towni0/TSEA29---MrRobot/README.md

# TSEA29---MrRobot
TSEA29 bygga robot projekt
test
