towni0/TSEA29---MrRobot/docs/TSEA29-presentation-v.01.pptx

## Mr.Robot

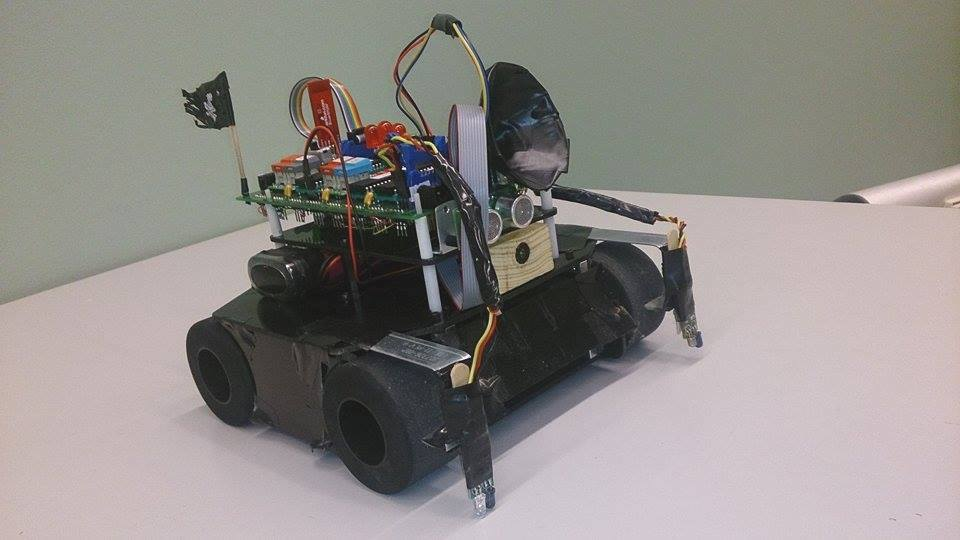
[picture p28: figure]

## INTRODUKTION

Namn | Ansvar
Johan Olin | Projektledare
Per Olin
Mattias Ulmstedt
Joacim Stålberg
Tor Utterborn | Dokumentationsansvarig
Hans Tchou

## Inledning

Bakgrund:
- TSEA29
- 6 gruppmedlemmar
Syfte:
- Lära oss mer om mikroprocessorer
- Arbeta i större projekt
Uppdrag:
- Konstruera en kamprobot
Budget:
- 960 timmar sammanlagt

## PRODUKT

Ingående i produkt:
  - Autonom kamprobot
  - Teknisk dokumentation
  - Användarmanual
  - Mjukvara till persondator

## Kamprobot

Vad kan roboten göra?
  - Åka runt i en bana
  - Skanna ett område efter fiender
  - Skjuta på fiender
  - Skicka sensordata till PC
  - Kollisionssäker*

*Väldigt liten chans att kollidera med något framför roboten

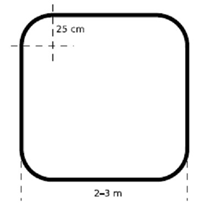
[picture p29: figure]

## Systemöversikt

- Tre delsystem

- UART

- Bluetooth


## Sensorenheten – ”Sinnena”

Ingående komponenter:
- Ultraljudssensor
- Lasersensor
- IR-sensor
- Tejpsensor x 2
- Gyro

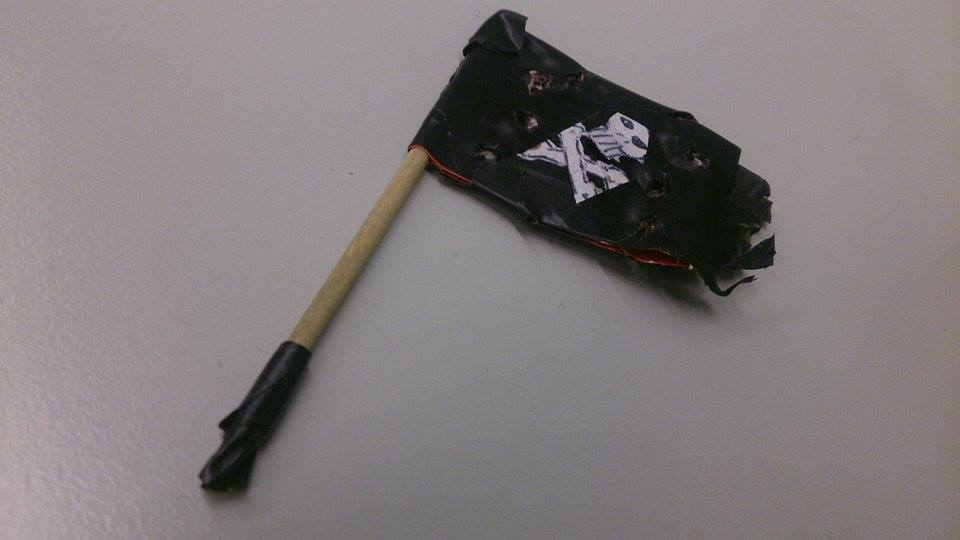
[picture p30: figure]

## Ultraljudssensor

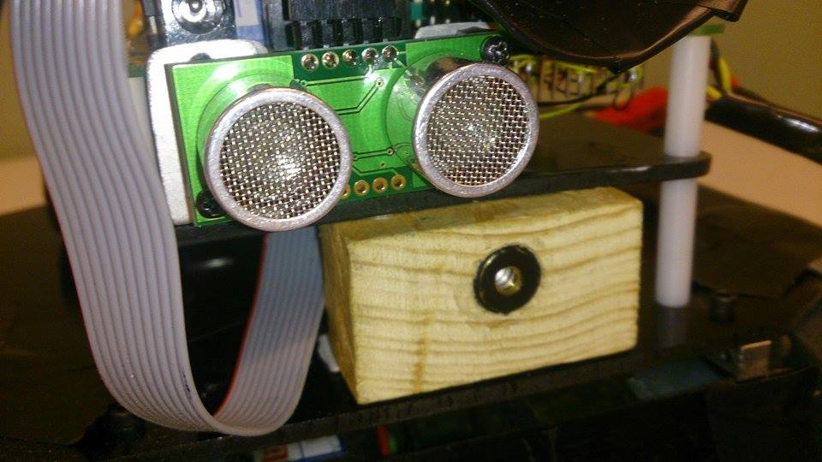
[picture p31: figure]

## Lasersensor

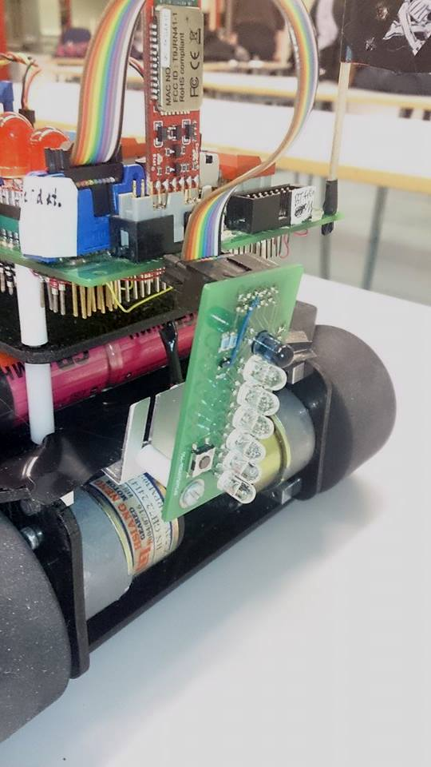
[picture p32: figure]

## IR-sensor

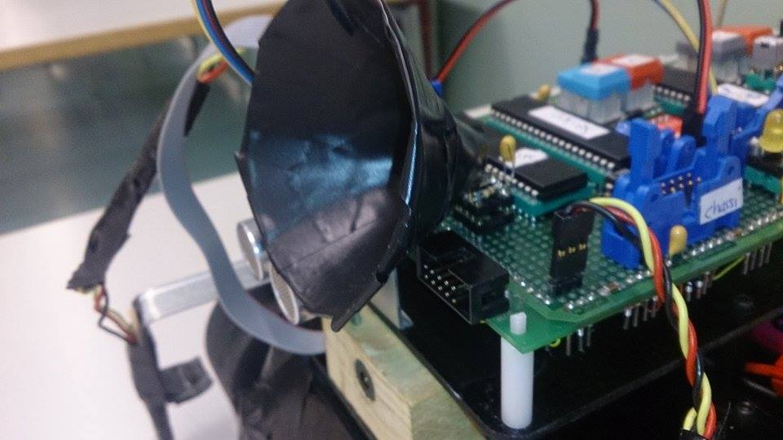
[picture p33: figure]

## Tejpsensor

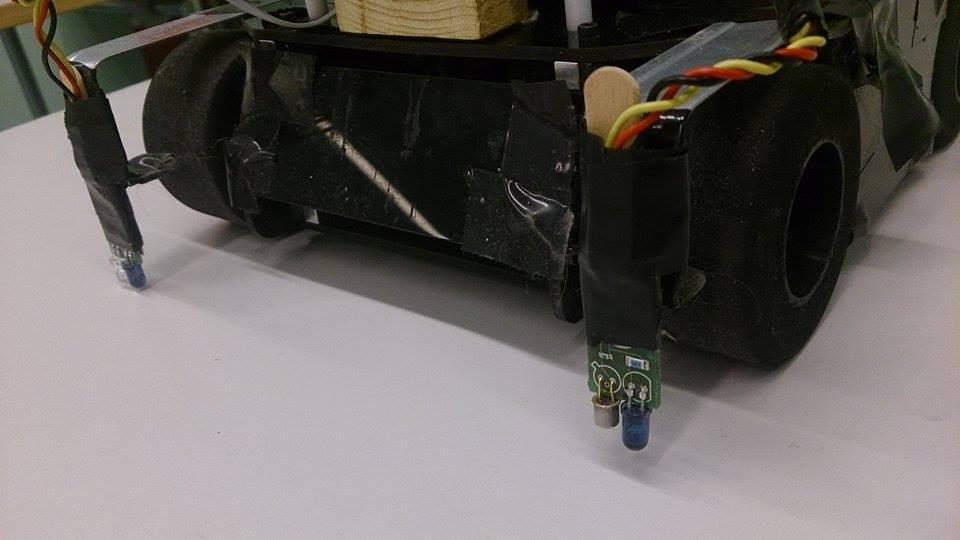
[picture p34: figure]

## Gyro

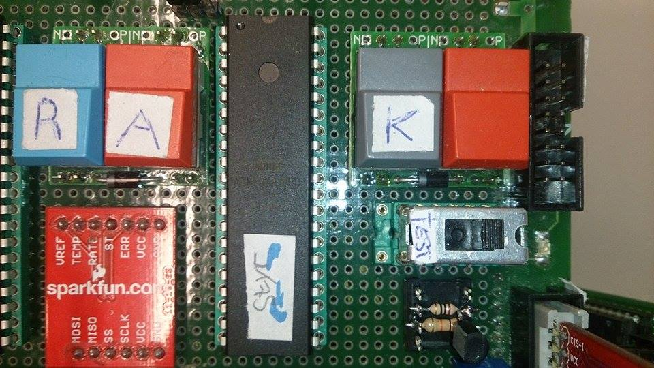
[picture p35: figure]

## Sensorenheten – ”Sinnena”

- Hämtar rådata från sensormoduler
- Skickar data till målsökningsenheten

## Målsökningsenheten – ”Hjärnan”

- ”Utför all logik”
- Skickar order till styrenheten
- AI – 2 olika lägen

## AI -


Notes: Om vi har tid kan man beskriva detta i en simplifierad version

## Styrenheten – ”Slaven”

Styrkomponenter:
- Två par motorer
- IR-sändare
- Laserkanon
- Lysdiod x 5

## IR-sändare

## Laserkanon

## Lysdioder

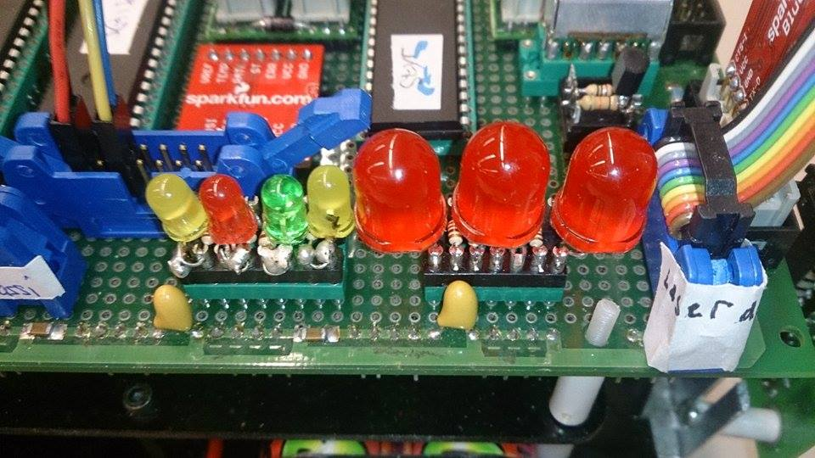
[picture p36: figure]

## Bluetooth - Firefly

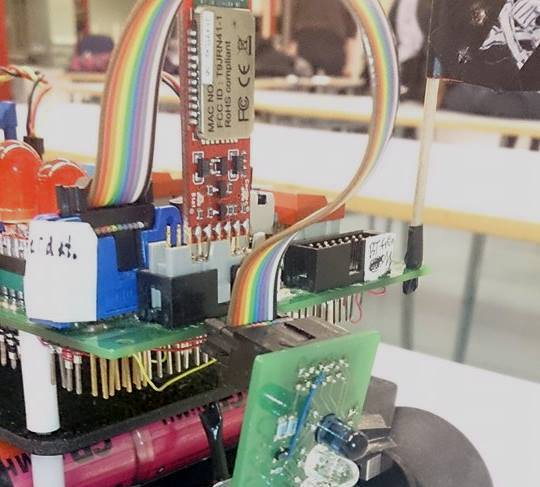
[picture p37: figure]

## Styrenheten – ”slaven”

- Bluetooth – enkelriktad
- Tar emot order från målsökningsenheten

## GUI


- Användning
- Kod: Java

## Arbetsmetod

- Nerifrån och upp  Lösning av problem: - Analysera - Brainstorm - Åtgärda
- Testa, testa, testa!

## Resultat

- En färdig produkt som uppfyller kravbild
- Leverans inom tidsram
- Som grupp mer erfarna och nöjda med produkten

## Slide 25

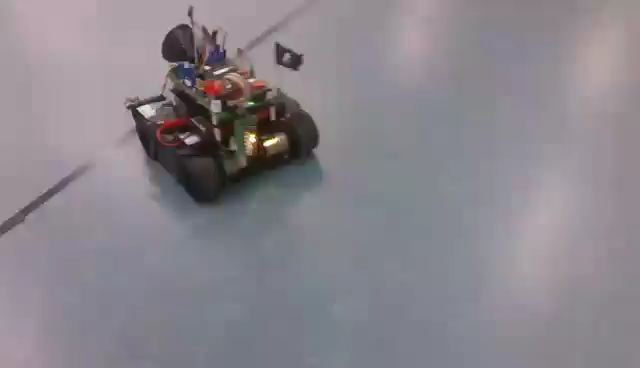
[picture p38: figure]

## Vidareutveckling

- Modulär
- Fjärrstyrning
- Oändliga möjligheter

## Varför oss?

- Potential (First!!111)
- Genomtänkt
- Ambitiöst

## Avslut

Frågor?
