towni0/TSEA29---MrRobot/docs/datablad/lasermodul.pdf

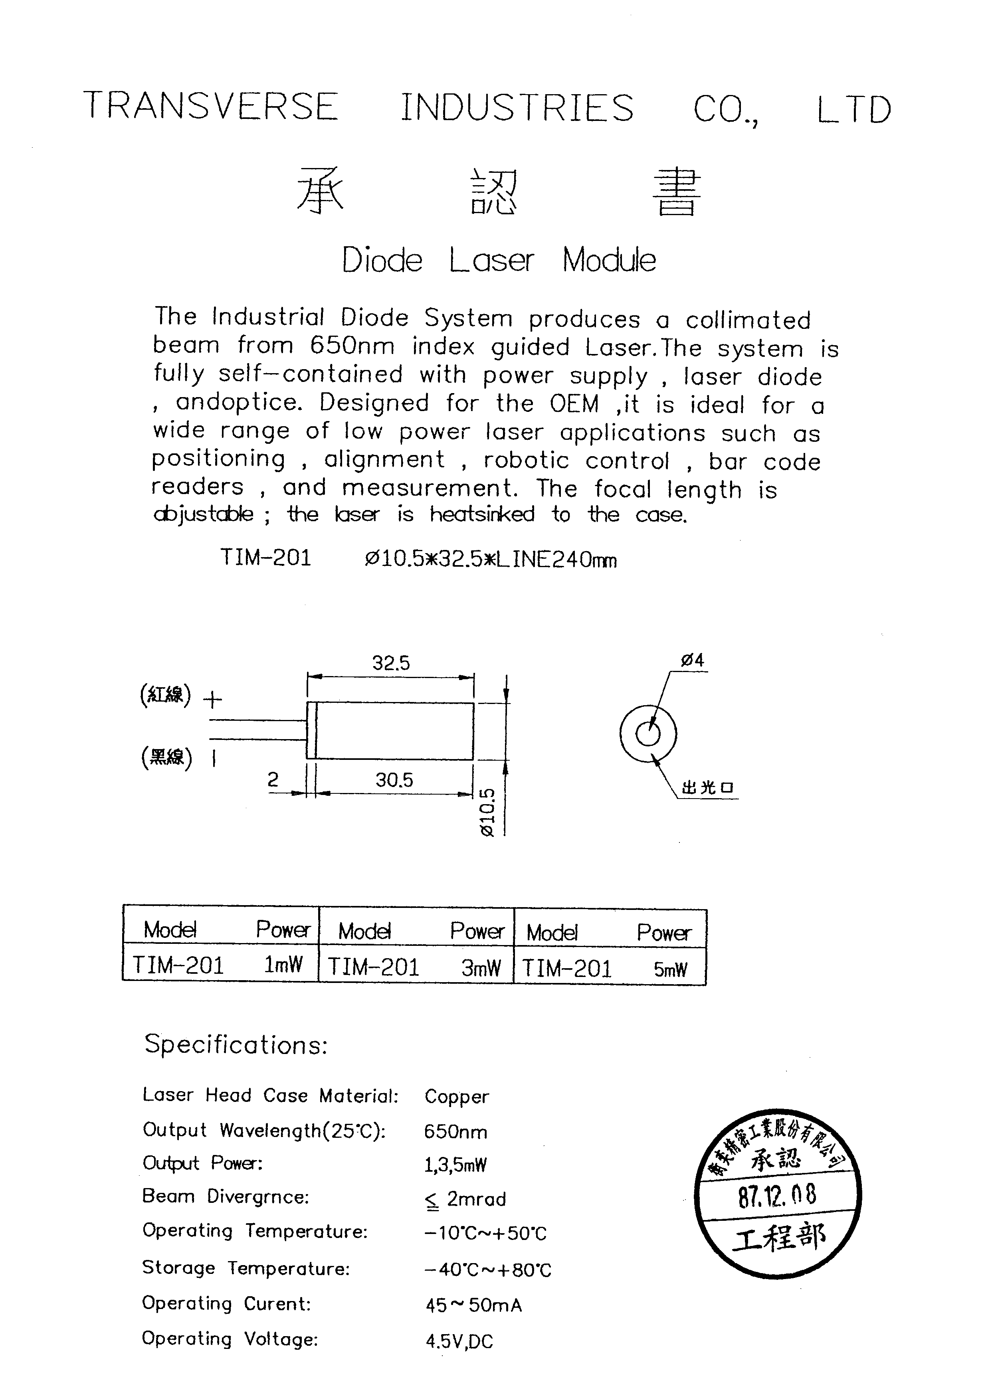
[picture p48: page 1]
