towni0/TSEA29---MrRobot/docs/TSEA29 - Kamprobot - Grupp 15 - Tiddsrapport 5.xlsx

Sheet: Basplan
Basplan
Projekt: |  | Kamprobot
Projektgrupp: |  | 15 |  | Datum: |  |  |  |  |  |  |  |  | Granskad:
Beställare: |  | Tomas Svensson |  | Version: |  | 1.0
Kurs: |  | TSEA29 |  | Utfärdare: |  | JO
AKTIVITETER |  |  | TID | VEM | TIDPLAN (när), veckonummer
Nr | Beskrivning |  | timmar | Initialer | 40 | 41 | 42 | 43 | 44 | 45 | 46 | 47 | 48 | 49 | 50 | 51 | 1 | 2 | 3 | 4 | 5 | 6 | 7 | 8 | 9 | 10 | 11
1 | Avståndssensorerna kan skicka data |  | 10 | JO,PO |  |  |  |  |  | 10 |  |  |  |  |  |  |  |  |  |  |  |  |  |  |  |  |  | 10
2 | Sensorenheten kan ange avstånd till föremål. |  | 10 | PO,JO |  |  |  |  |  | 10 |  |  |  |  |  |  |  |  |  |  |  |  |  |  |  |  |  | 10
3 | IR-sensorn kan skicka data till sensorenheten |  | 10 | TU,HT |  |  |  |  |  | 10 |  |  |  |  |  |  |  |  |  |  |  |  |  |  |  |  |  | 10
4 | Sensorenheten kan identifiera en “fyr” |  | 10 | HT,TU |  |  |  |  |  | 10 |  |  |  |  |  |  |  |  |  |  |  |  |  |  |  |  |  | 10
5 | Linjesensorn kan skicka data till sensorenheten |  | 10 | MU,JS |  |  |  |  |  | 10 |  |  |  |  |  |  |  |  |  |  |  |  |  |  |  |  |  | 10
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
