towni0/TSEA29---MrRobot/docs/pics/målsökningsenhet.png

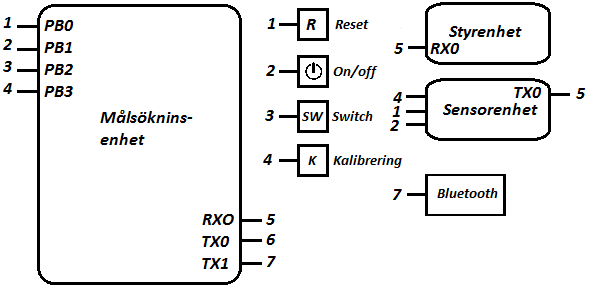
docs/pics/målsökningsenhet.png
