towni0/TSEA29---MrRobot/docs/pics/Sensorenhet.png

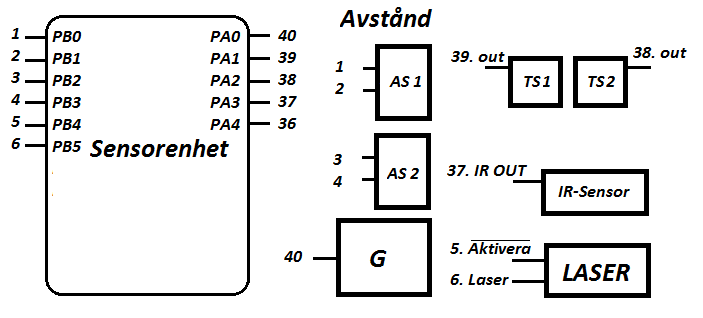
docs/pics/Sensorenhet.png
