towni0/TSEA29---MrRobot/docs/pics/Systembild.png

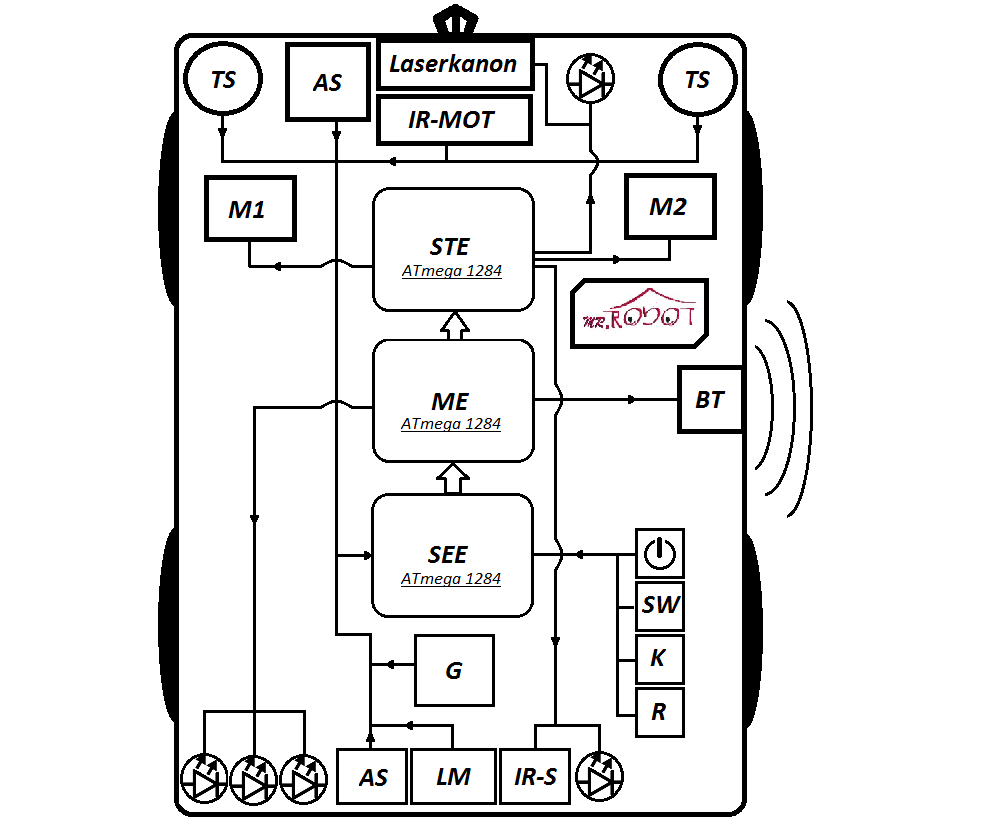
docs/pics/Systembild.png
