towni0/TSEA29---MrRobot/docs/pics/Systembildv3.png

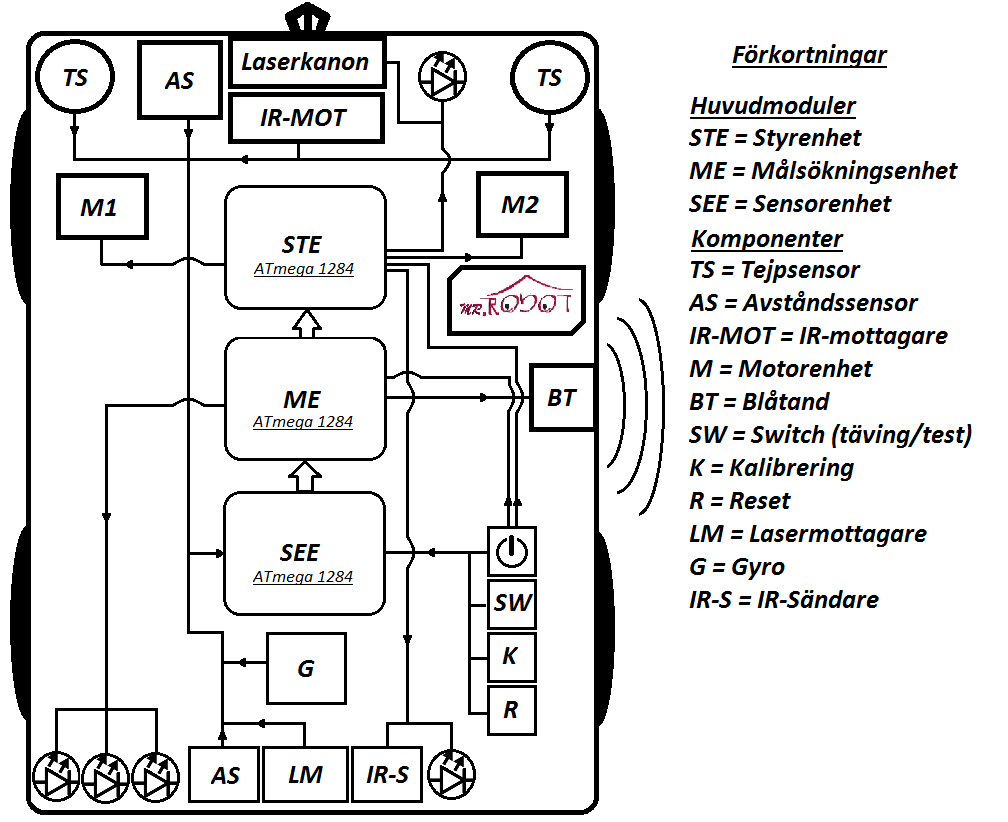
docs/pics/Systembildv3.png
