towni0/TSEA29---MrRobot/code/Sensorenheten/Sensorenheten/Sensorenheten.cpp

/*
 * Sensorenheten
 * 
 * TSEA29 Group 15
 * Programmerare: Joacim Stålberg, Mattias Ulmstedt, Tor Utterborn, Hans Tchou, Johan Olin och Per Olin.
 * LIU
 */ 

#include "../../Robotdefinitions.h"
#include "util/delay.h"

#define GYRO		0
#define TAPESENSOR1 1
#define TAPESENSOR2 2

//initial values are set to their IDs from design spec. (these bits are never changed)
uint8_t message1 = 0b00110000;
uint8_t message2 = 1;
uint8_t message3 = 2;
uint8_t message4 = 3;
uint8_t message5 = 4;

uint8_t ADCcount = 1;

uint8_t messageNumber = 1;


void waitForActivationSensor();
uint8_t tapeCheck(uint16_t message, uint8_t tapeSensorNumber);
void clearADCMUX();

//###############
//## IR SENSOR ##
//###############

#define IRheader 20
#define IROneValueMin 9
#define IROneValueMax 13
#define IRZeroValueMin 4

bool compareSignature(uint8_t* oursignature, uint8_t* signature);
void IRSensorFunction();
bool enemy = false;
uint8_t signature[] = {0,0,0};
uint8_t signatureS = 0;
uint8_t oursignature[] = {1,1,0};
int index = 0;
int IRcount = 0;
bool headerPhase = false;
bool signaturePhase = false;
bool pause = false;

//########################
//## Ultrasonic Sensors ##
//########################

void ultrasonicFunction();
void StartPulse();
void CalculateTime();
void resetTimerValues();
float calculateDistance();

// Variables
int timer = 0;

uint8_t distancecm1 = 0; //Ultrasonic sensor 1 distance [cm]
uint8_t distance1 = 0; //Ultrasonic sensor 1 distance [dm]

bool triggerStarted = false;
bool triggerSend = false;

bool timerStarted = false;
bool timeTaken = false;

//laser
void laserSensorFunction();

uint8_t laser;
uint8_t secsSinceLaserHit = 0;
bool waitLaserActivation = false;
bool laserIniated = false;


int main(void)
{
	//init µcontroller
	DDRD &= ~(1<<PIND7); //Aktiveringsknapp (in)
	DDRB = 0b00011110;
		
	//enable global interrupt
	sei();
	
	//Ultrasonic
	TCCR2B |= 1 << CS20; // Start timer
	TCNT2 = 0;
	
	//###############
	//## ADC INITS ##
	//###############
		
	//turn on ADC
	ADCSRA |= (1 << ADEN);
	//Set ADC clock to 1000 000 / 128 Hz
	ADCSRA |= (1 << ADPS2) | (1 << ADPS1) | (1 << ADPS0) ;
	//ADC interrupt enabled
	ADCSRA |= (1 << ADIE);
	//mux PINA0, start with TAPE
	ADMUX |= (1<<PINA0);
	
	//################
	//## UART INITS ##
	//################
	
	//initiate UART målsökning
	//set baud rate
	uint16_t UBRR_val = UBRR_SENSOR_MALSOKNING;
	UBRR0H = (unsigned char) (UBRR_val >> 8);
	UBRR0L = (unsigned char) UBRR_val;
	//enable transmit + set frame 8 bits
	UCSR0B = (1<<TXEN0);
	UCSR0C = (1<<UCSZ00) | (1<<UCSZ01);
	//enable transmit interrupt
	UCSR0B |= (1<<TXCIE0);
	
	//inactivate, must wait for power up
	_delay_ms(100);
	PORTB |= (1 << LASER_AKTIVERA_PORT);
	_delay_ms(10);
	PORTB &= ~(1 << LASER_AKTIVERA_PORT);
	
	//## IR Sensor ##
	TCCR1B |= 1 << CS10;
	
	//Start 1st ADC conversion
	ADCSRA |= (1 << ADSC);
	
	waitForActivationSensor();
	
	//start first UART transmission
	UDR0 = 0x00;
	
	//Main loop
    while(1)
    {
		//###############
		//## IR SENSOR ##
		//###############

		IRSensorFunction();
		
		//##################
		//## Laser sensor ##
		//##################
		
		laserSensorFunction();
		
		//########################
		//## Ultrasonic Sensors ##
		//########################
		
		ultrasonicFunction();
	}
	
}

/*
	Interrupt function for sending UART
*/
ISR(USART0_TX_vect){
	cli();
	//mux through messages
	switch(messageNumber){
		case 1:
			UDR0 = message1;
			break;
		case 2:
			UDR0 = message2;
			break;
		case 3:
			UDR0 = message3;
			break;
		case 4:
			UDR0 = message4;
			break;
		case 5: 
			UDR0 = message5;
			break;
	}
	
	//next mux
	messageNumber++;
	if(messageNumber>NUMBER_OF_MESSAGES) messageNumber=1;
	
	//enable interrupts
	sei();
}

/*
	Interrupt function for ADC
*/
ISR(ADC_vect){
	cli();
	uint8_t lowbits = ADCL;
	uint16_t message = ADCH <<8 | lowbits;
	//enable interrupts
	sei();
	uint8_t inbetween = 0;
	switch(ADCcount){
		case GYRO:
			message >>= 2; //Divide by 4
			message4 &= 0b00000111; //Reset bits
			message4 |= (message<<LOWERBITSGYRO_INDEX);
			message5 &= 0b11000111; //Reset bits
			message5 |= ((message>>2) & 0b00111000);
			clearADCMUX();
			ADMUX |= 1;
			break;
		case TAPESENSOR1:
			//clear TAPESENSOR1_INDEX bit
			message5 &= 0b10111111;
			tape1CurrentValue = message; //Save current value, used for calibration
			//mask in actual value
			//debug
			message3 &= 0b00000111;
			inbetween = (message >> 5);
			message3 |= (inbetween << 3);
			//!!!
			message5 |= (tapeCheck(message, 1)<<TAPESENSOR1_INDEX);
			//next muxed ADC
			clearADCMUX();
			ADMUX |= 2;
			break;
		case TAPESENSOR2:
			//clear TAPESENSOR2_INDEX bit
			message5 &= 0b01111111;
			tape2CurrentValue = message; //Save current value, used for calibration
			//mask in actual value
			message5 |= (tapeCheck(message, 2)<<TAPESENSOR2_INDEX);
			//next muxed ADC
			clearADCMUX();
			//MUX to IRSENSOR-ADC?
			break;
	}
	
	ADCcount++;
	//go around
	if(ADCcount >= NUMBER_OF_ADC_SENSORS){
		 ADCcount = 0;
		 clearADCMUX();
	}
	
	//Start next conversion
	ADCSRA |= (1 << ADSC);
}

/*
	Check if the converted value from the tape sensors indicate tape or not.
	Returns 1 if tape.
*/
uint8_t tapeCheck(uint16_t message, uint8_t tapeSensorNumber){
	if((tapeSensorNumber == 1 && message >= tape1Threshold) || (tapeSensorNumber == 2 && message >= tape2Threshold)){
		return 1;
	}
	else{
		return 0;
	}
}

/*
	Resets the MUX counter for the ADC.
*/
void clearADCMUX(){
	ADMUX &= 0b11100000;
}

/*
	Resets timer 2.
*/
void resetTimerValues() {
	TCNT2 = 0;
	timer = 0;
}

/*
	Startpulse for the ultrasonic sensor.
*/
void StartPulse() {
	//set trigger to high
	if (!triggerStarted) {
		triggerStarted = true;
		PORTB |= (1 << PULSE_TRIGGER_PIN1);
		resetTimerValues();
	}
	
	//set trigger to low
	if (triggerStarted && timer == 10) { // and at least 15 us has passed.
		triggerSend = true;
		PORTB &= ~(1 << PULSE_TRIGGER_PIN1);
		resetTimerValues();
	}
}


/*
	Calculates the time that the pulse to took return.
*/
void CalculateTime() {
	//when echo output is high, start timer.
	if (!timeTaken && triggerSend && !timerStarted && (PINB & (1<<ECHO_PIN1))) {
		timerStarted = true;
		resetTimerValues();
		
	}
	
	//when echo output is low, stop timer. (save time)
	if (!timeTaken && triggerSend && timerStarted && !(PINB & (1<<ECHO_PIN1))) {
		//set timer variables to zero.
		// CalculateDistance returns a value in cm we need it in dm
		distancecm1 = calculateDistance();
		//check singular number to do correct round up or down
		int singular = (distancecm1 % 100) % 10;
		if(singular >= 5){ 
			distance1 = distancecm1/10 + 1;
		}
		else{
			distance1 = distancecm1/10;
		}
		message2 &= ~(0b11111<<3); //Reset distance bits
		message2 |= (distance1<<3); //Set UART message with new distance
		
		resetTimerValues();
		timeTaken = true;
	}
}


/*
	Returns the distance from the ultrasonic sensor.
*/
float calculateDistance() {
	//each timer tick represent MICRO_SEC_PER_TICK ms
	int uTime = timer * MICRO_SEC_PER_TICK;
	//magic formula to get centimeter
	float centiMeters = uTime/58;
	//cap max distance to 240 cm because faulty sensor at high values
	if (centiMeters > 240) return 240;
	return centiMeters;
}

/*
	Returns true if the signatures are the same.
*/
bool compareSignature(uint8_t* oursignature, uint8_t* signature){
	for (int i = 0; i<3;i++){
		if (oursignature[i] != signature[i]){
			return false;
		}
	}
	return true;
}

/*
	Checks for hit and reactivates the laser sensor 5 seconds after hit.
*/
void laserSensorFunction(){
	if(TCNT3 >= 18000){
		secsSinceLaserHit++;
		TCNT3 = 0;
	}
	if(secsSinceLaserHit >= 5){
		//inactivate
		PORTB |= (1 << LASER_AKTIVERA_PORT);
		//reset count
		if(!waitLaserActivation){
			TCNT3 = 0;
			waitLaserActivation = true;
		}
		//activate, might have to wait if this is too fast here we wait 10 more clock ticks
		if(TCNT3 >= TICKS_TO_WAIT_FOR_ACTIVATE_LASER){
			PORTB &= ~(1 << LASER_AKTIVERA_PORT);
			TCCR3B &= 0b11111000; //Reset pre-scaler to stop counting
			TCNT3 = 0; //Reset counter
			secsSinceLaserHit = 0;
			waitLaserActivation = false;
		}
	}
	
	//mask LASER bit
	laser = (PINB>>5);
	laser &= 0b00000001;
	if(laser == 0b00000001){
		message1 &= 0b10111111; //Reset laser bit
		message1 |= (laser<<LASER_INDEX); //Mask in new laser bit
		//Start timer with pre-scaler 1024
		TCCR3B |= (1<<CS32) | (1<<CS30);
	}
	else{
		//no hit
		message1 &= 0b10111111;
	}
}

/*
	Drive the ultrasonic sensor and calculate distance
*/
void ultrasonicFunction(){
	//in here every 100 us
	if (TCNT2 > 184) {
		PORTC ^= (1<<PINC1);
		timer++;
		TCNT2 = 0;
	}
	
	if (!triggerSend) {
		StartPulse();
	}
	CalculateTime();
	
	//wait at least 10msec
	if (timeTaken && timer == 1000) {
		triggerSend = false;
		triggerStarted = false;
		timerStarted = false;
		timeTaken = false;
	}
}

/*
	Wait for press on activation button.
*/
void waitForActivationSensor(){
	while((PIND>>PIND7) == 0){
		//Calibrate tape sensor if the calibration button is pressed.
		if((PINB>>PINB7) == 0){
			cli();
			tape1Threshold = tape1CurrentValue - TAPE1_ERROR_MARGIN; 
			tape2Threshold = tape2CurrentValue - TAPE2_ERROR_MARGIN; 
			sei();
		}
	}
	return;
}



/*
	Reads IR-signatures from the IR-sensor
*/
void IRSensorFunction(){
	// If 100 us have passed
	if (TCNT1 > 1842){ //Timer counter
		IRcount++;
		TCNT1 = 0;
	}
	
	//start with looking for header
	if(!headerPhase && !signaturePhase){
		if(bit_is_clear(PINB, 6)){ // check if header can start
			headerPhase = true;
			IRcount = 0;
		}
	}
	else if(headerPhase && !signaturePhase){
		//if header is too short or long redo
		if(bit_is_set(PINB, 6) && ((IRcount < IRheader) || (IRcount > IRheader + 6))){
			headerPhase = false;
		}
		else if(bit_is_set(PINB, 6) && IRcount >= IRheader){
			signaturePhase = true;
			index = 0;
			IRcount = 0;
			pause=true;
		}
	}
	
	if(signaturePhase){
		//pauses should be detected as +~400us signals
		if(pause){
			//if the pause is too short or long we have a mess
			if(bit_is_clear(PINB, 6) && ((IRcount < 5) || (IRcount > 7))){
				signaturePhase = false;
				headerPhase = false;
			}
			//if pause is between ~300 to 700 we accept it
			else if(bit_is_clear(PINB, 6)){
				pause=false;
				IRcount = 0;
			}
		}
		else{
			//if signal was too short or too long we have mixed signal or header
			if(bit_is_set(PINB, 6) && ((IRcount < IRZeroValueMin) || (IRcount > IROneValueMax))){
				signaturePhase = false;
				headerPhase = false;
			}
			//accept ~1100 to 2000us as a 1
			else if(bit_is_set(PINB, 6) && IRcount > IROneValueMin){
				signature[index] = 1;
				index++;
				pause = true;
				IRcount = 0;
			}
			//accept 3-10 as a 0 ~300 us to 1000 us
			else if(bit_is_set(PINB, 6)){
				signature[index] = 0;
				index++;
				pause = true;
				IRcount = 0;
			}
		}
	}
	
	//if full signature has been picked up
	if(index == 3){
		if (compareSignature(oursignature, signature)){
			enemy = false;
		}
		else {
			enemy = true;
		}
		headerPhase = false;
		signaturePhase = false;
		index = 0;
		IRcount = 0;
		
		//Set UART message
		signatureS = (signature[0]<<2) | (signature[1]<<1) | signature[2];
		message1 &= ~(0b111<<IRSIGNATURE_INDEX); //Reset signature in message
		message1 |= (signatureS<<IRSIGNATURE_INDEX); //Set new signature
		(enemy ? message1 |= (1<<IRSENSOR_INDEX) : message1 &= ~(1<<IRSENSOR_INDEX));
		//send signature in message3 for debug(old ultrasonic sensor 2)
		message3 &= 0b00000111;
		message3 |= (signatureS << 3);
	}
	
	//update with our signature (default) if no signature spotted
	if (IRcount == IRheader * 10){
		enemy = false;
		//Set UART message
		signatureS = (oursignature[0]<<2) | (oursignature[1]<<1) | oursignature[2];
		message1 &= ~(0b111<<IRSIGNATURE_INDEX); //Reset signature in message
		message1 |= (signatureS<<IRSIGNATURE_INDEX); //Set new signature
		(enemy ? message1 |= (1<<IRSENSOR_INDEX) : message1 &= ~(1<<IRSENSOR_INDEX));
		//send signature in message3 for debug(old ultrasonic sensor 2)
		message3 &= 0b00000111;
		message3 |= (signatureS << 3);
	}
	
}
