towni0/TSEA29---MrRobot/(commit log)

2015-10-07 Dokument som beskriver laserkanon, lasersensor samt tejpsensor tillagda
2015-10-07 IR-Sensor, Systembild new file: docs/IR-sensor.docx new file: docs/datablad/ir-sensor-8601s.pdf new file: docs/pics/Systembild.png
2015-10-13 Create Pseudokod Sensorenhet
2015-10-13 motorer och sensorenhet pseudo
2015-10-14 Lagt till ADC BT Gyrotext
2015-10-14 kompletterande IR-sensor
2015-10-22 Uppdaterat designspecifikation till v1.0 samt ändra de saker Olov ville att vi skulle ändra
2015-11-03 Tidsplan
    Lagt in tidsplan
    [TSEA29MRROBOT1.0.xlsx]
2015-11-15 Projekt mappar till atmelstudio styrenhet, sensorenhet, målsöknings, lasersensor
2015-11-19 Tog bort all gammal text vi använde för att skapa designspecifikationen
    [TSEA29MRROBOT1.0.xlsx]
2015-11-19 Lagt in orginal tidsplanering
    [TSEA29 Grupp 15 Orginal Tidsplan.xlsx]
2015-11-20 Fixat 80% av styrenheten klar
    [Robotdefinitions.h]
2015-11-20 Uppdaterade Styrenhets kodens switch sats
2015-11-23 "Kalibreringsknapp flyttad till Sensorenhet"
2015-11-23 Lagt in tidsrapport 4
    [TSEA29 - Kamprobot - Grupp 15 - Tiddsrapport 4.xlsx]
2015-11-25 Lagt till lite saker i MS- abs gyro
2015-11-25 Fixat PWM
2015-11-25 Lagt till så vi visar gyro rotation istället för vinkelhastighet
2015-11-25 fix i MS rotations kod
    [Malsokningsenheten.cpp]
2015-11-26 Fixat saker i MS, SE och lagt till rätt värden för BT i dokumentation
    [Malsokningsenheten.cpp, Robotdefinitions.h]
2015-11-26 Fixat en test kod för AI
    [Malsokningsenheten.cpp]
2015-11-27 försök på gyro
2015-11-28 gyro funkar + lite ai hålla sig någorlunda innanför en bana
2015-11-29 Lagt till IR sändare samt fixat mer "clean" kod
    [Styrenheten.cpp]
2015-11-29 försök till att få rätt ultraljudssensorn men fail
    [Malsokningsenheten.cpp, Sensorenheten.cpp]
2015-11-29 Lagt in tidsrapport 5 (för vecka 48)
    [TSEA29 - Kamprobot - Grupp 15 - Tiddsrapport 5.xlsx]
2015-12-03 queue implementerad så att styrenheten kan skicka ut över uart
2015-12-07 Lagt tillden senste tidsrapporten
    [TSEA29 - Kamprobot - Grupp 15 - Tiddsrapport 6.xlsx]
2015-12-09 end of the day commit linje sensor och så funkar, inget glapp
2015-12-10 Lagt till flowchart till tävlingskod
2015-12-13 förhoppningsvist fixat instabil styrenhet
    flyttat lite leds
    [Robotdefinitions.h, Sensorenheten.cpp, Styrenheten.cpp]
2015-12-15 fixat saker
    [TSEA29 - Kamprobot - Grupp 15 - Tiddsrapport 7.xlsx]
2015-12-17 fixat zip med källkod i code mappen
    [Malsokningsenheten.cpp, Robotdefinitions.h, Sensorenheten.cpp, Styrenheten.cpp]
2015-12-18 tek dok, efterstuie o tidsrapport
    [TSEA29 - Kamprobot - Grupp 15 - Tiddsrapport 8.xlsx]
